chanisma/dxldog/docs/parts.md

# 부품 선정과 BOM

조사일: 2026-10-11 (가격은 ROBOTIS US 스토어 기준). ⚠️ 표시는 확인되지 않은 값이다.

## 1. 모터 선정: 시뮬레이션으로 정했다
- 모델: SpotMicro 치수(`sim/dog_model.py`). 질량은 CAD로 계산한 프린트 부품 무게에 모터·배터리·전자부품을 더했다. XL 구성 1.71 kg, XM 구성 1.91 kg.
- 방법: 모터 최대 힘을 각 모터의 **정지 토크(12 V)**로 제한하고 동작을 시켰다. 성공 여부와 함께 **RMS 토크 ÷ 정지 토크**(평균 부하율)를 쟀다.
- 기준: 서보는 평균 부하가 정지 토크의 약 30–40 %를 넘으면 오래 쓸 때 과열되기 쉽다(일반적인 경험칙 ⚠️).

| 모터 | 정지 토크 @12 V | 1개 가격 | 서기 (무릎) | 보통 걸음 (무릎 / 엉덩이) | 빠른 걸음 | 판단 |
|---|---|---|---|---|---|---|
| XL430-W250 | 1.5 Nm | $27.50 | 26 % | 성공, 58 % / 54 % | 성공, 75 % / 74 % | 서기·자세는 충분. **오래 걸으면 과열 위험** |
| XC430-W240 | 1.9 Nm | $137.89 | 21 % | 성공, 47 % / 43 % | 성공, 61 % / 55 % | XL보다 5배 비싸고 27 %만 셈 → 비추천 |
| XM430-W210 | 3.0 Nm | $310.39 | 15 % | 성공, 31 % / 30 % | 성공, 41 % / 37 % | 괜찮음 (더 빠름: 77 rpm) |
| **XM430-W350** | 4.1 Nm | $310.39 | 11 % | 성공, 23 % / 22 % | 성공, 30 % / 28 % | **여유 있음** |

추가로 확인한 것:
- **옆으로 벌리기(hip_x) 관절은 부하가 작다.** 평균 0.15–0.3 Nm라 XL430으로 충분하다. 그래서 권장 구성은 이 4개만 XL430으로 한다.
- **로봇을 80–90 % 크기로 줄여도** 걸을 때 XL430 부하는 40–55 %다. 걷는 동안의 부하는 몸무게보다 다리를 움직이는 동작에서 주로 오므로, 크게 줄지 않는다. 그래서 SpotMicro 원래 크기를 유지했다(`sim/scale_study.py`).
- 걸음새를 느리게 하면 부하가 줄어든다. XL430 기준: 빠름 69 % → 보통 61 % → 느림 51 % (`sim/gait_sweep.py`, CAD 반영 전 질량).
- 참고 논문(Open Ant, arXiv 2607.18488, 요약만 확인 ⚠️): 0.98 kg 로봇에서 XL430은 힘이 부족했고 XM430-W350은 충분했다고 보고했다.

## 2. 구성별 BOM (로봇 1대)
### 공통
| 품목 | 수량 | 가격 | 비고 |
|---|---|---|---|
| U2D2 (USB ↔ DYNAMIXEL) | 1 | $36.92 | PC나 Raspberry Pi에서 Python으로 제어 |
| U2D2 Power Hub Board Set | 1 | $21.85 | 3.5–24 V 입력을 모터 버스에 공급 |
| 12 V 직류 전원 (10 A 이상) | 1 | 약 $20–30 ⚠️ | 수업용 기본. XM430 8개를 쓰면 15 A 권장 ⚠️ |
| 3S LiPo 1300 mAh (ROBOTIS LB-020) + 충전기 LBC-010 | 선택 | $41.17 + $17.83 | 완충 12.6 V는 XL430 최대 12 V를 넘음 → 6장 참고 |
| IMU (예: BNO055) | 1 | 약 $30 ⚠️ | 기울기 측정 (J4 무게중심 실험) |
| Raspberry Pi 5 또는 4 | 선택 | 약 $60–80 ⚠️ | 몸에 싣는 두뇌. 윗판에 58×49 mm 구멍 있음 |
| 5 V 강압 변환기 (12 V → 5 V, Pi 5는 5 A / Pi 4는 3 A) + microSD 32 GB | Pi를 쓸 때 | 약 $15–25 ⚠️ | 모터 전원(12 V)에서 Pi 전원을 만든다 ([rpi_setup.md](rpi_setup.md)) |
| 필라멘트 PETG(또는 PLA) | 약 0.6 kg | – | 프린트 부품 합계 약 510 g (채움 30 % 어림) |
| TPU 필라멘트 | 소량 | – | 발 4개 |
| 나사 | 아래 표 | – | |

### 모터 (등급별)
| 등급 | 구성 | 모터 합계 | 공통 포함 합계(어림, Pi·배터리 제외) |
|---|---|---|---|
| 입문 | XL430-W250 × 12 | $330 | 약 $440 |
| **권장** | XL430-W250 × 4 (hip_x) + XM430-W350 × 8 (hip_y, knee) | $110 + $2,483 = **$2,593** | 약 $2,700 |
| 여유 | XM430-W350 × 12 | $3,725 | 약 $3,830 |

XL430 가격 $27.50은 2025년 $49.90에서 내린 값이다. 결제할 때 다시 확인한다 ⚠️.

### 나사 (1대 기준)
| 쓰임 | 나사 | 수량 |
|---|---|---|
| 포크 팔 ↔ 혼·아이들러 | M2 × 5–6 (팔 4 mm, 머리 자리 1.5 mm). STS3215는 M3 × 6 ([sts.md](sts.md)) | 관절 12 × 8 = 96 (XM은 혼 구멍이 8개지만 4개씩만 써도 됨) |
| 하우징·몸통 판 ↔ 모터 옆면 | XL/XC: M2.6 × 6 탭핑, XM: M2.5 × 6 | 모터 12 × 8 = 96 |
| 몸통 기둥 (위·아래 판) | M3 × 8 탭핑 | 8 |
| 발 ↔ 정강이 | M3 × 12 탭핑 | 4 |
| Raspberry Pi | M2.5 × 6 + 스페이서 | 4 |

XL430 상자에는 M2.6 탭핑 나사와 M2 볼트가 들어 있다(조사 요약 ⚠️). 부족한 양만 따로 산다.

## 3. 배선
- DYNAMIXEL TTL(3핀)을 줄줄이 잇는다(데이지 체인). 한 줄에 서보 3개 이하로 나누면 전류와 고장 위치를 관리하기 쉽다(커뮤니티 권장 ⚠️). 다리 하나를 한 줄로 하면 4줄 → Power Hub에서 나눈다.
- ID 배정 예시: FL 1·2·3, FR 4·5·6, RL 7·8·9, RR 10·11·12 (hip_x, hip_y, knee 순). 통신 속도 1 Mbps.

## 4. 전원 주의
- XL430: 6.5–12 V (권장 11.1 V). XM430: 10–14.8 V (권장 12 V). **섞어 쓸 때는 12 V 고정 전원**이 둘 다의 범위 안이다.
- 3S LiPo는 완충하면 12.6 V로 XL430 최대치를 넘는다(펌웨어 한계 14 V라 멈추지는 않지만 규격 밖이다). 배터리를 쓰려면 12 V 강압 레귤레이터를 넣는다 ⚠️ 대전류 레귤레이터를 따로 골라야 함.
