chanisma/dxldog/cad/out/sts/thigh_FR.step

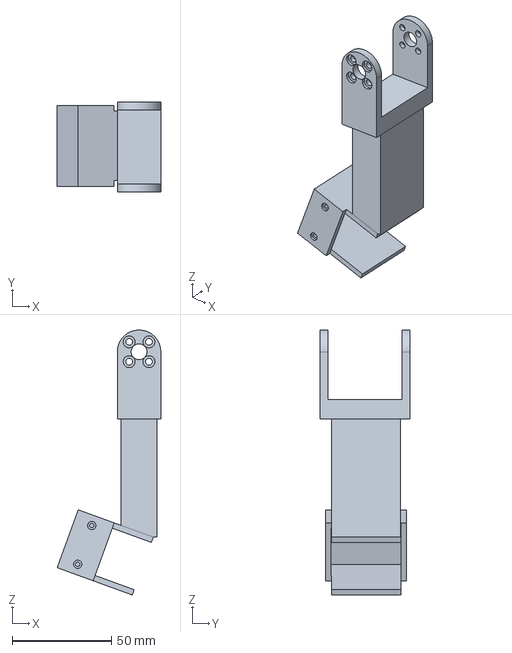
[picture p5: CAD file, 2026-10-14]
cad/out/sts/thigh_FR.step
52.4 x 45.4 x 133.8 mm
