chanisma/dxldog/cad/out/v2/sts/body_top.step

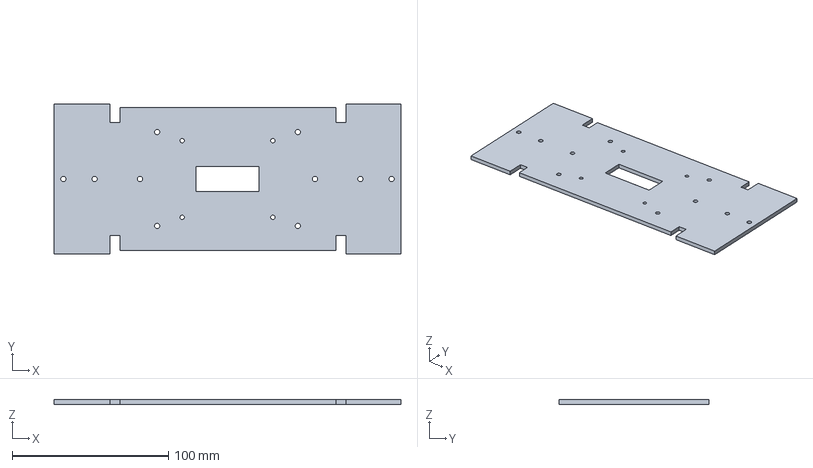
[picture p6: CAD file, 2026-10-14]
cad/out/v2/sts/body_top.step
222.0 x 96.0 x 3.00 mm
