chanisma/dxldog/software/dxldog/assets/mixed/shank_R.stl

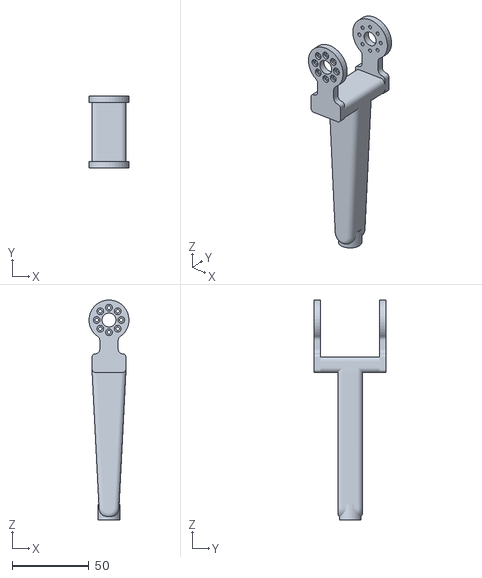
[picture p7: CAD file, 2026-10-11]
software/dxldog/assets/mixed/shank_R.stl
26.0 x 46.6 x 143.0
