chanisma/dxldog/software/dxldog/assets/sts/thigh_L.stl

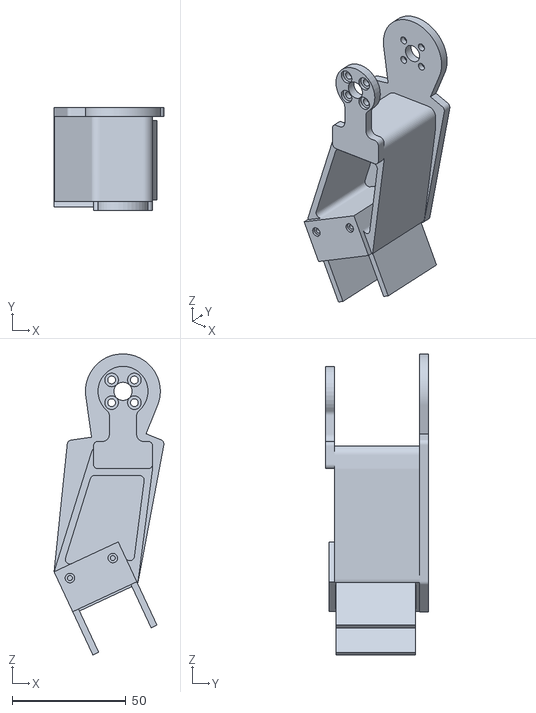
[picture p8: CAD file, 2026-10-14]
software/dxldog/assets/sts/thigh_L.stl
48.3 x 45.4 x 132.3
