chanisma/dxldog/cad/out/v2/mixed/gauge_side_holes.step

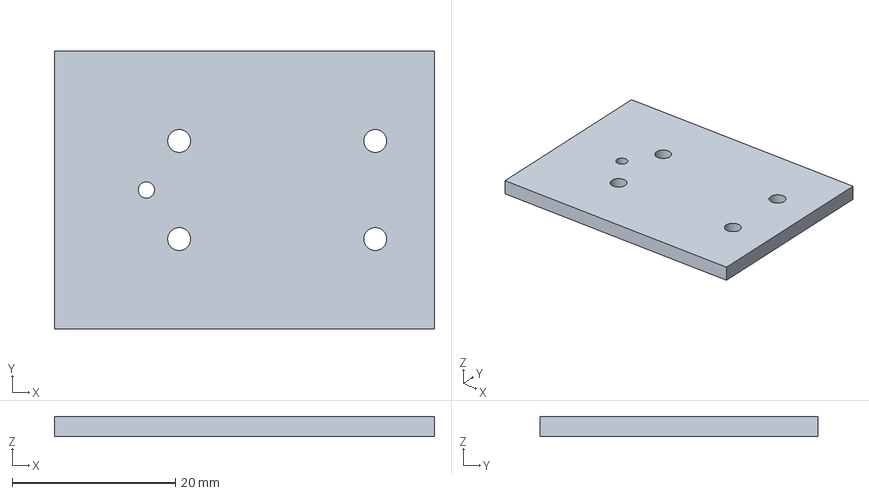
[picture p9: CAD file, 2026-10-11]
cad/out/v2/mixed/gauge_side_holes.step
46.5 x 34.0 x 2.50 mm
