chanisma/dxldog/cad/out/v2/sts/cover_mid.step

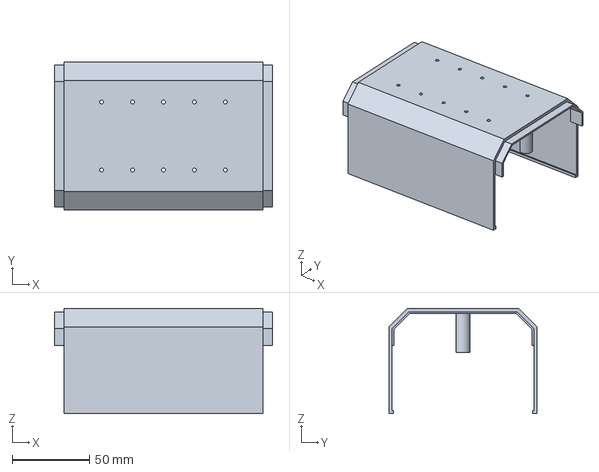
[picture p10: CAD file, 2026-10-14]
cad/out/v2/sts/cover_mid.step
141.0 x 96.0 x 68.0 mm
