chanisma/dxldog/software/dxldog/assets/mixed/body_bottom.stl

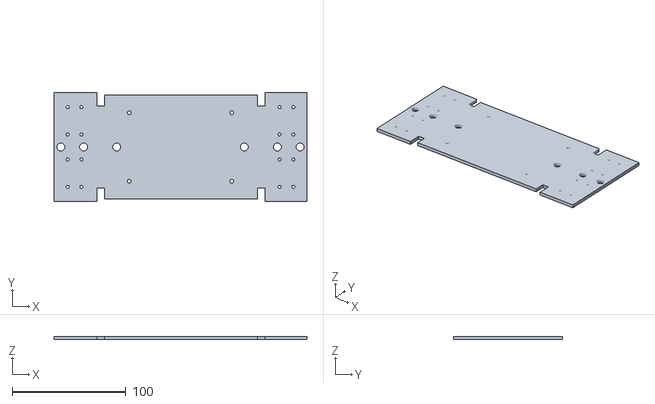
[picture p11: CAD file, 2026-10-11]
software/dxldog/assets/mixed/body_bottom.stl
222.0 x 96.0 x 3.00
