chanisma/dxldog/cad/out/sts/body_pillar.step

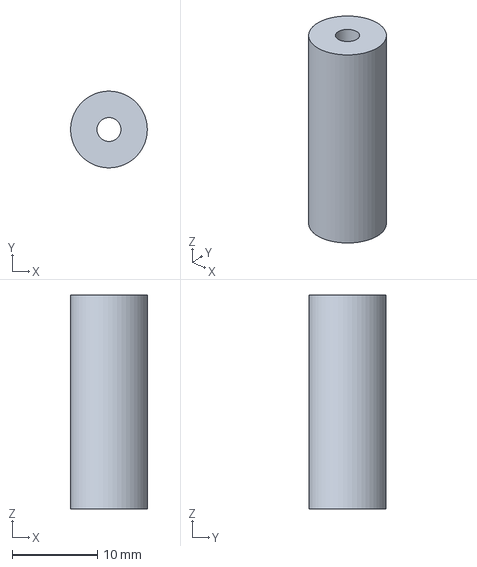
[picture p12: CAD file, 2026-10-14]
cad/out/sts/body_pillar.step
8.99 x 9.00 x 25.1 mm
