chanisma/dxldog/cad/out/v2/mixed/rail.step

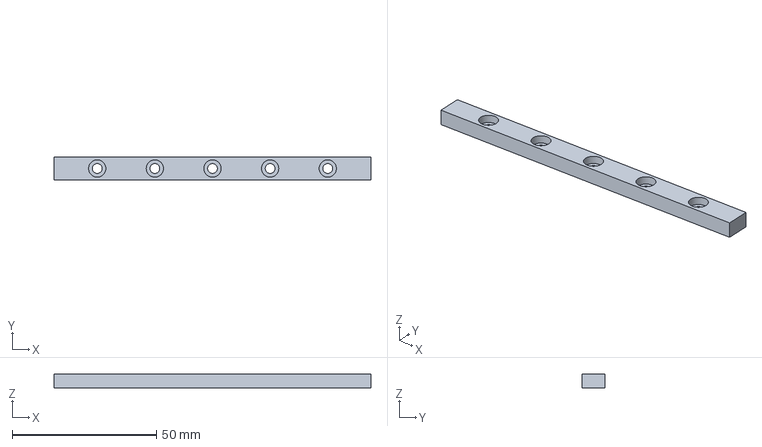
[picture p13: CAD file, 2026-10-11]
cad/out/v2/mixed/rail.step
110.0 x 8.00 x 5.00 mm
