chanisma/dxldog/software/dxldog/assets/mixed/shoulder_R.stl

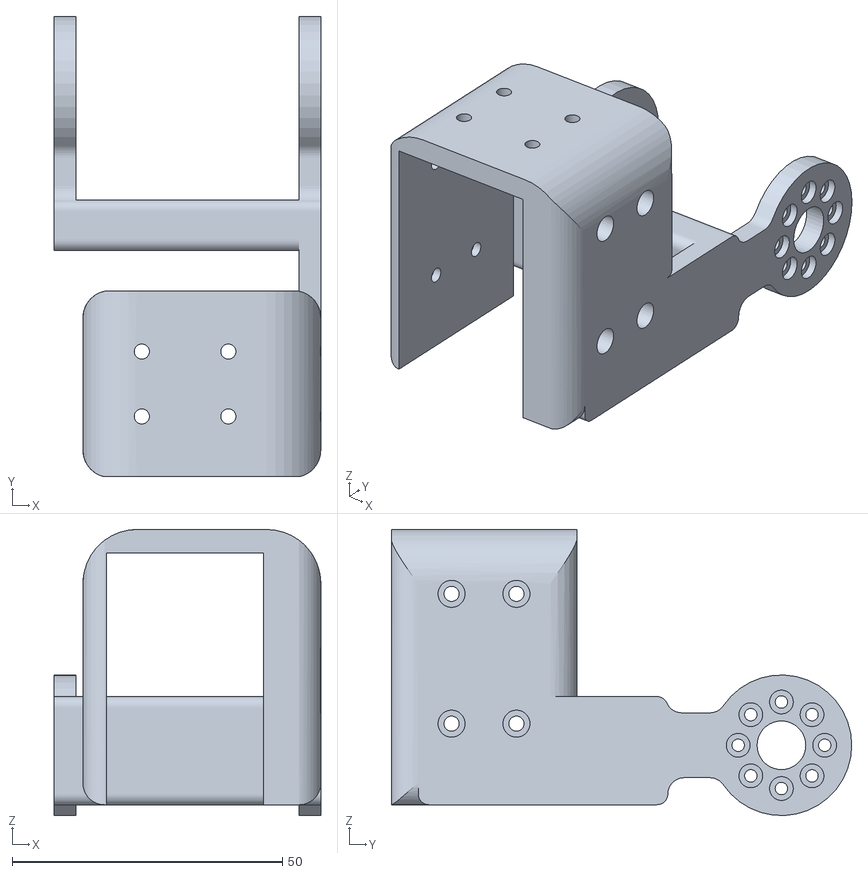
[picture p14: CAD file, 2026-10-11]
software/dxldog/assets/mixed/shoulder_R.stl
49.3 x 85.2 x 52.9
