chanisma/dxldog/software/dxldog/assets/sts/shoulder_R.stl

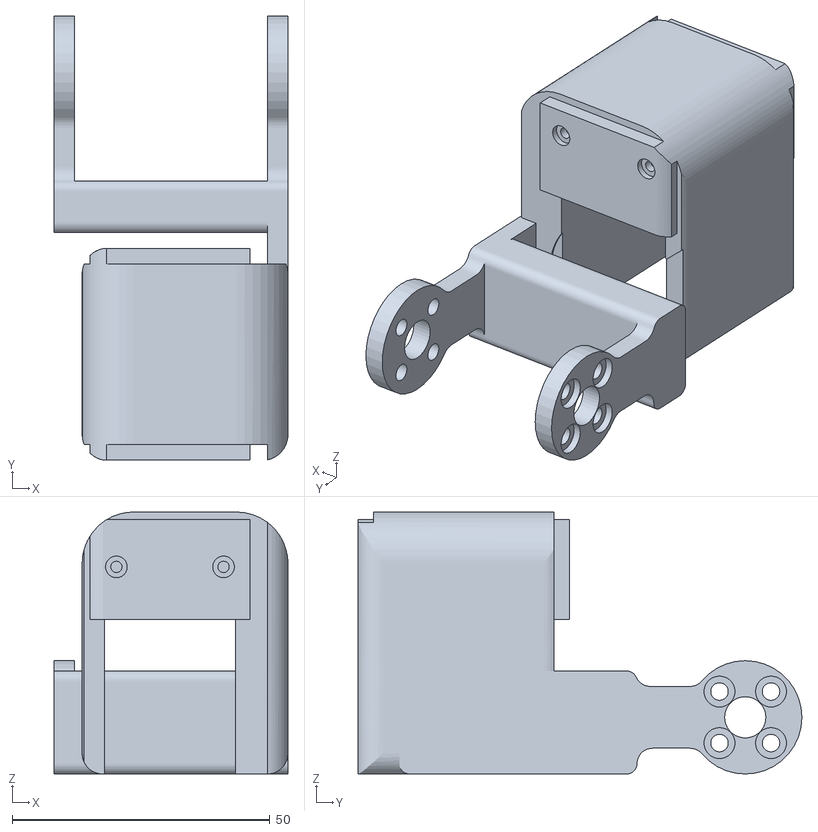
[picture p15: CAD file, 2026-10-14]
software/dxldog/assets/sts/shoulder_R.stl
45.4 x 86.2 x 50.8
