chanisma/dxldog/cad/out/v2/mixed/thigh_FR.step

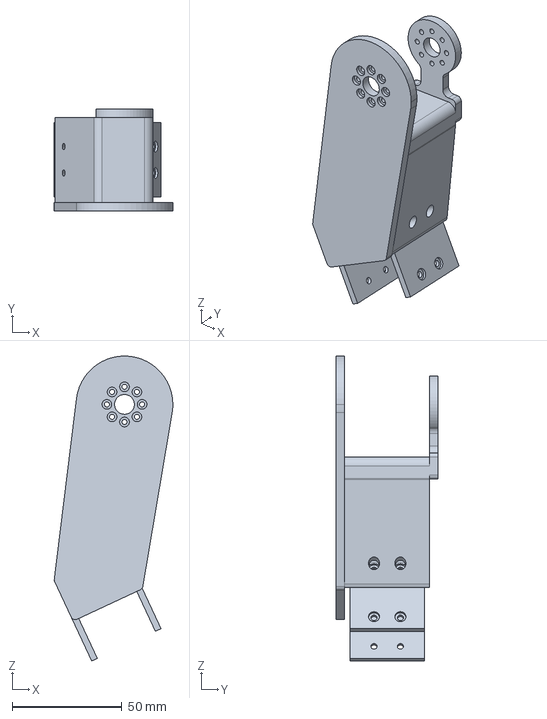
[picture p16: CAD file, 2026-10-11]
cad/out/v2/mixed/thigh_FR.step
54.0 x 46.6 x 138.7 mm
