chanisma/dxldog/software/dxldog/assets/mixed/cover.stl

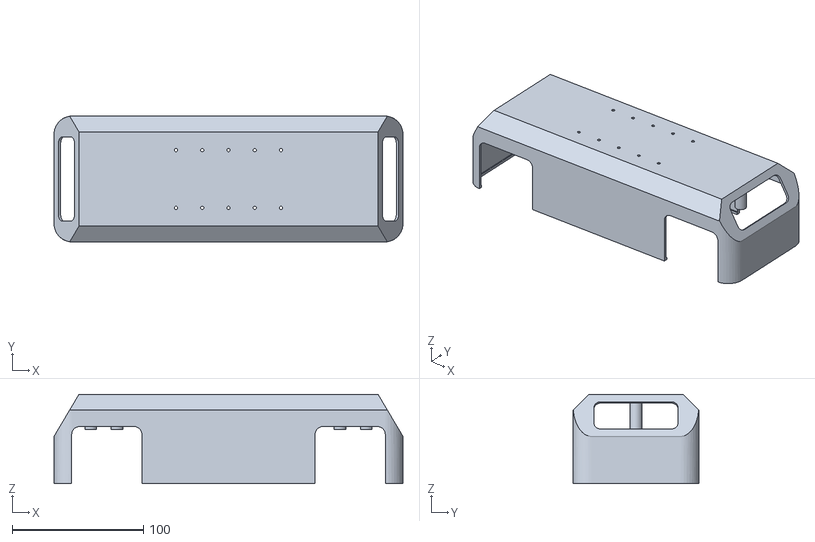
[picture p17: CAD file, 2026-10-11]
software/dxldog/assets/mixed/cover.stl
266.0 x 96.0 x 68.0
