chanisma/dxldog/software/dxldog/assets/sts/body_bottom.stl

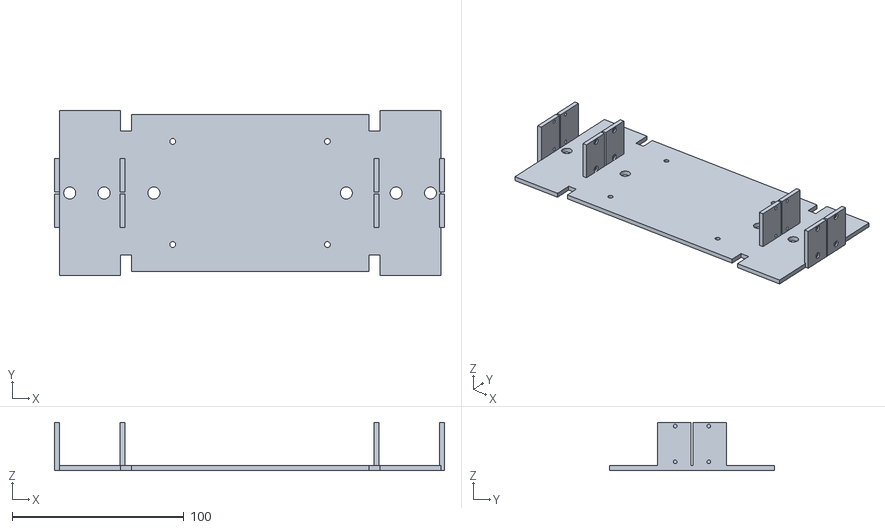
[picture p18: CAD file, 2026-10-14]
software/dxldog/assets/sts/body_bottom.stl
227.0 x 96.0 x 28.1
