chanisma/dxldog/cad/out/sts/shank_FR.step

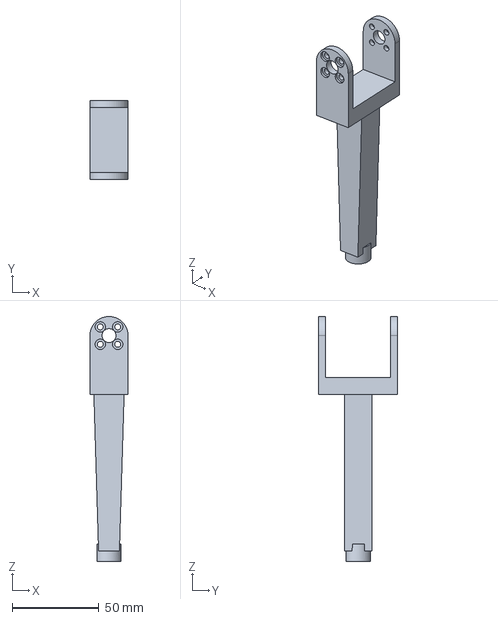
[picture p19: CAD file, 2026-10-14]
cad/out/sts/shank_FR.step
22.0 x 45.4 x 141.0 mm
