chanisma/dxldog/cad/out/v2/sts/gauge_face_top.step

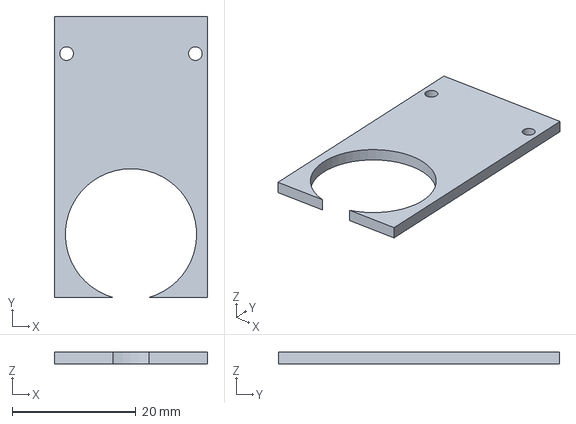
[picture p20: CAD file, 2026-10-14]
cad/out/v2/sts/gauge_face_top.step
24.8 x 45.4 x 2.00 mm
