chanisma/dxldog/cad/out/v2/sts/gauge_case_ring.step

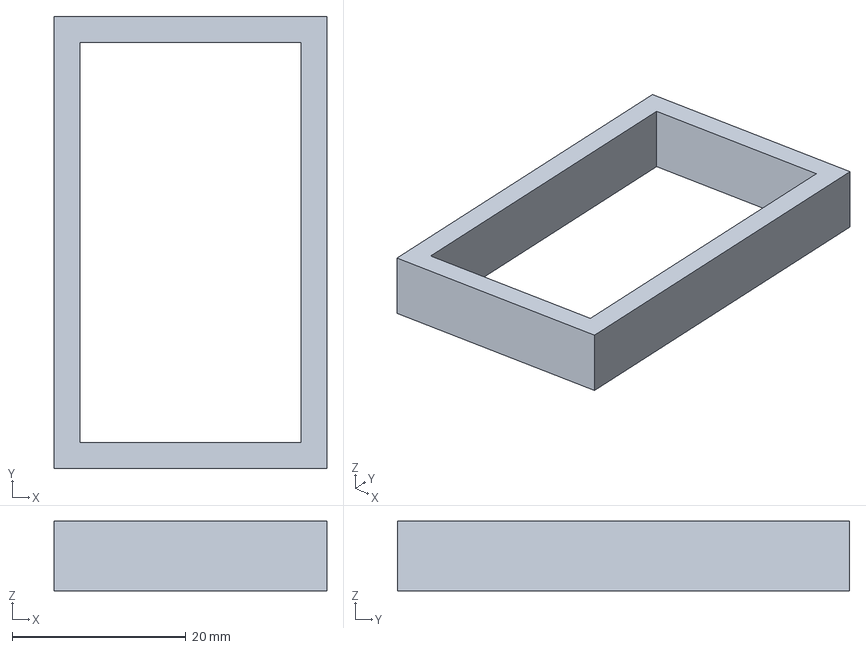
[picture p21: CAD file, 2026-10-14]
cad/out/v2/sts/gauge_case_ring.step
31.4 x 52.0 x 8.00 mm
