chanisma/dxldog/software/dxldog/assets/sts/shank_R.stl

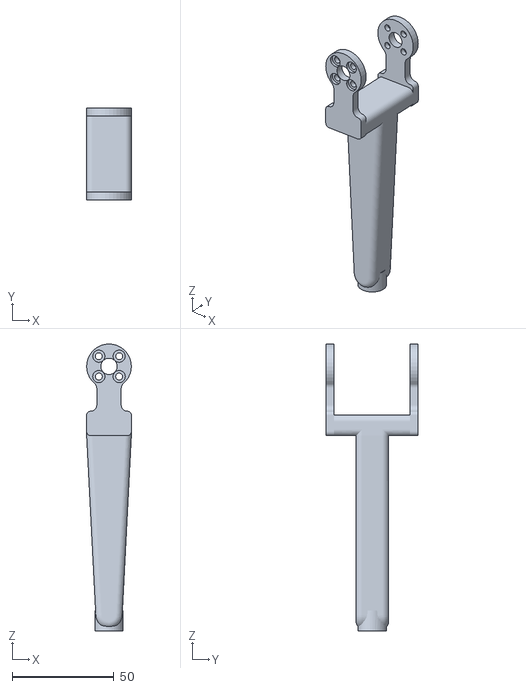
[picture p22: CAD file, 2026-10-14]
software/dxldog/assets/sts/shank_R.stl
22.0 x 45.4 x 141.0
