chanisma/dxldog/cad/out/sts/body_bottom.step

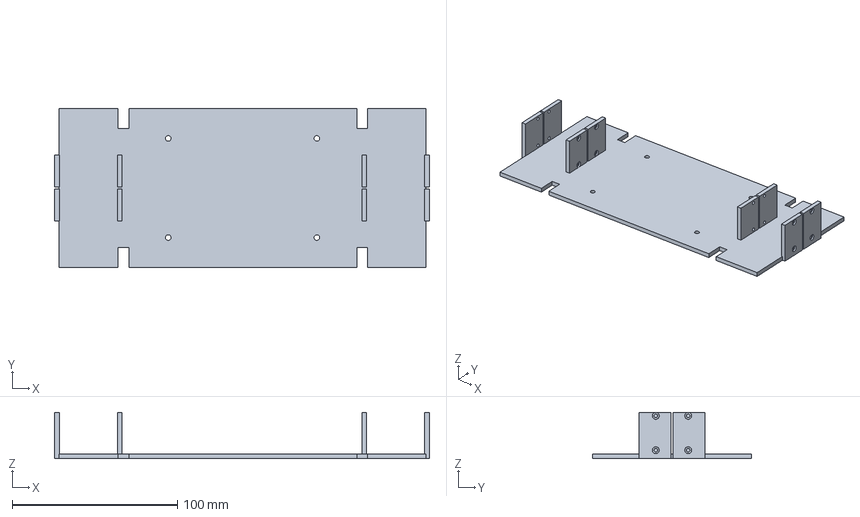
[picture p23: CAD file, 2026-10-14]
cad/out/sts/body_bottom.step
227.0 x 96.0 x 28.1 mm
