chanisma/dxldog/cad/out/v2/mixed/body_pillar.step

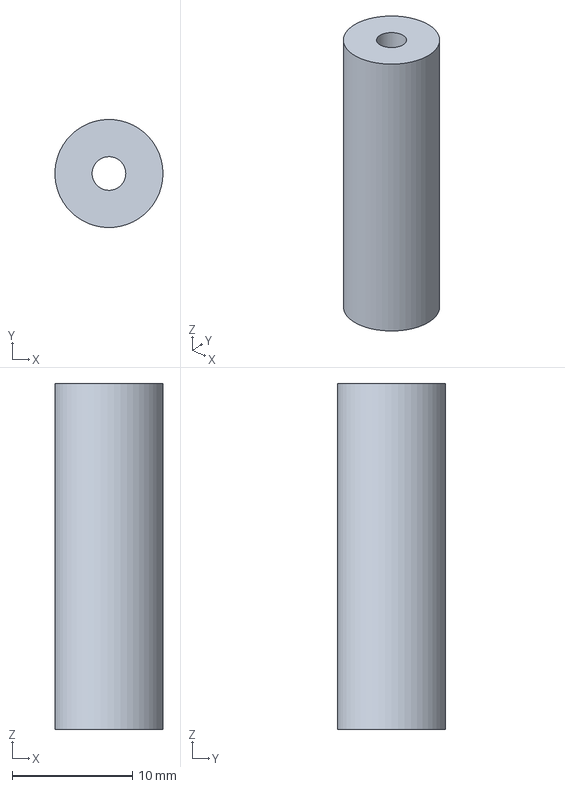
[picture p24: CAD file, 2026-10-11]
cad/out/v2/mixed/body_pillar.step
8.99 x 9.00 x 28.8 mm
