chanisma/dxldog/cad/out/sts/shoulder_FL.step

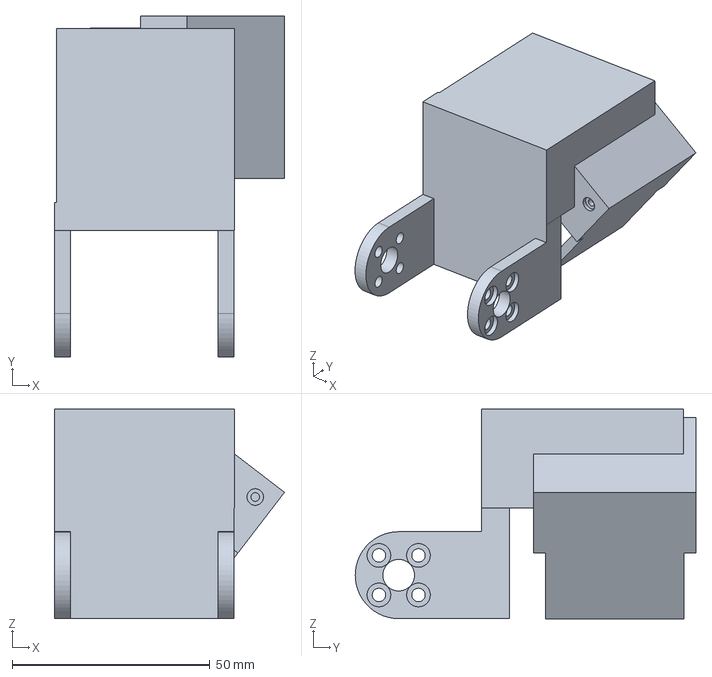
[picture p25: CAD file, 2026-10-14]
cad/out/sts/shoulder_FL.step
58.2 x 86.2 x 53.1 mm
