chanisma/dxldog/cad/out/v2/mixed/cover_end.step

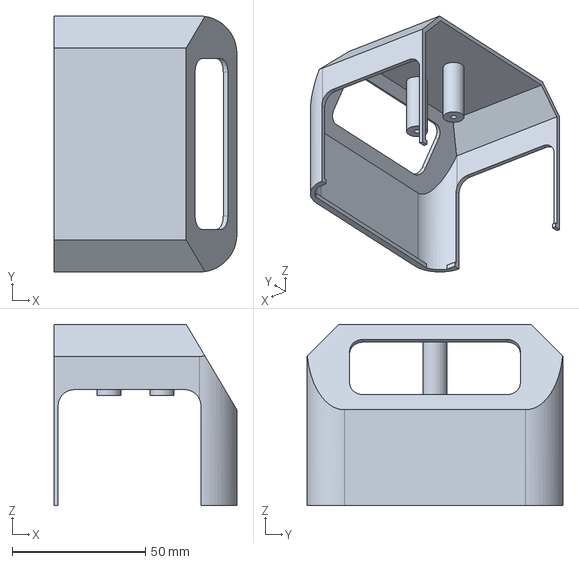
[picture p26: CAD file, 2026-10-11]
cad/out/v2/mixed/cover_end.step
68.5 x 96.0 x 68.0 mm
