chanisma/dxldog/software/dxldog/assets/mixed/cover_dark.stl

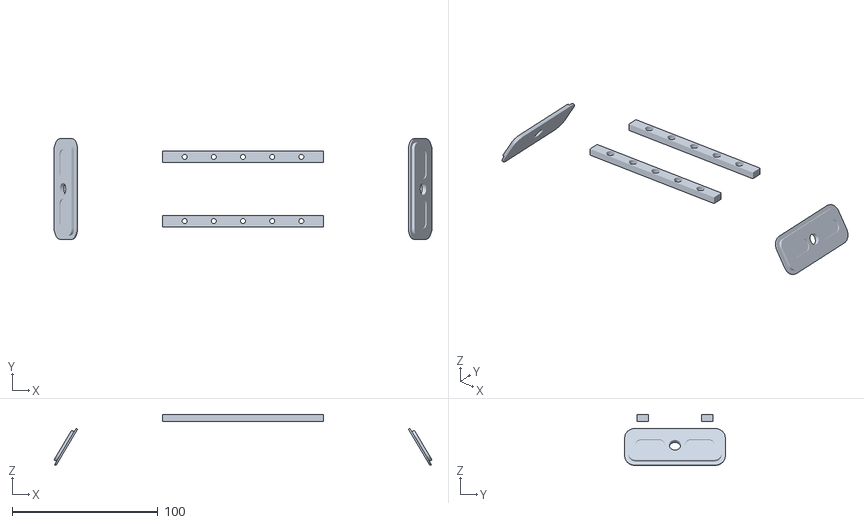
[picture p27: CAD file, 2026-10-11]
software/dxldog/assets/mixed/cover_dark.stl
259.0 x 69.0 x 35.1
