chanisma/dxldog/cad/out/sts/foot.step

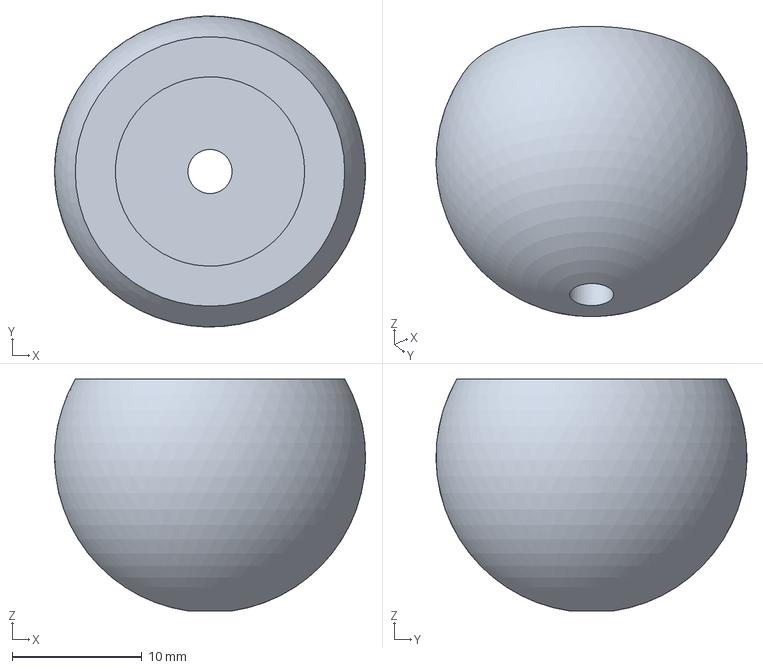
[picture p28: CAD file, 2026-10-14]
cad/out/sts/foot.step
24.0 x 24.0 x 17.9 mm
