chanisma/dxldog/cad/out/v2/mixed/gauge_horn.step

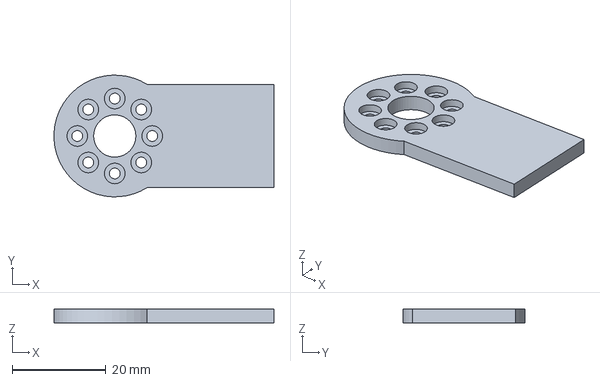
[picture p29: CAD file, 2026-10-11]
cad/out/v2/mixed/gauge_horn.step
47.0 x 26.0 x 3.00 mm
