chanisma/dxldog/cad/out/v2/mixed/cover_mid.step

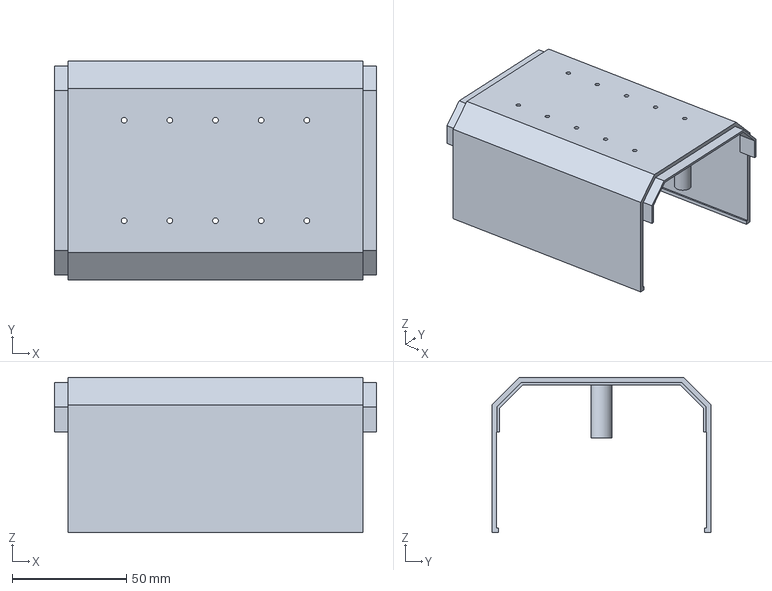
[picture p30: CAD file, 2026-10-11]
cad/out/v2/mixed/cover_mid.step
141.0 x 96.0 x 68.0 mm
