chanisma/dxldog/cad/out/sts/gauge_horn.step

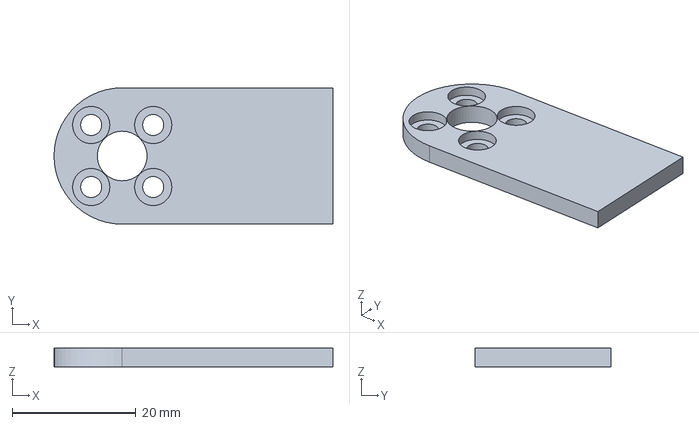
[picture p31: CAD file, 2026-10-14]
cad/out/sts/gauge_horn.step
45.0 x 22.0 x 3.00 mm
