chanisma/dxldog/cad/out/v2/sts/face_plate.step

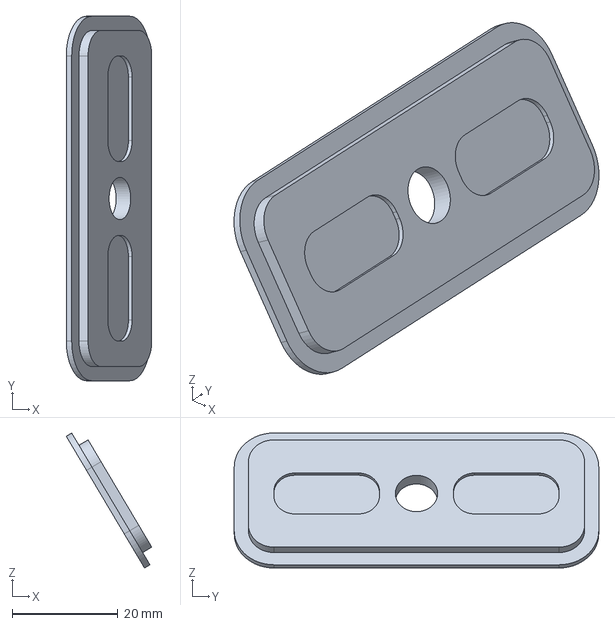
[picture p32: CAD file, 2026-10-14]
cad/out/v2/sts/face_plate.step
16.2 x 69.0 x 25.5 mm
