chanisma/dxldog/cad/out/v2/mixed/gauge_case_ring.step

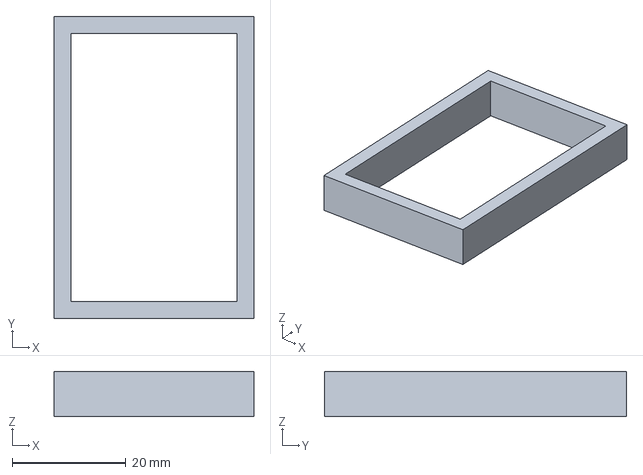
[picture p33: CAD file, 2026-10-11]
cad/out/v2/mixed/gauge_case_ring.step
35.1 x 53.1 x 8.00 mm
