chanisma/dxldog/(list of files, cad)

Other CAD files:
software/dxldog/assets/sts/thigh_R.stl
cad/out/v2/sts/thigh_FR.step
cad/out/sts/thigh_FL.step
cad/out/v2/mixed/body_bottom.step
software/dxldog/assets/mixed/shoulder_L.stl
software/dxldog/assets/sts/shoulder_L.stl
cad/out/sts/body_top.step
cad/out/v2/mixed/thigh_FL.step
software/dxldog/assets/mixed/body_top.stl
cad/out/v2/mixed/shank_FL.step
cad/out/v2/sts/body_bottom.step
software/dxldog/assets/mixed/shank_L.stl
software/dxldog/assets/sts/shank_L.stl
cad/out/sts/shank_FL.step
cad/out/v2/mixed/shoulder_FL.step
cad/out/v2/sts/gauge_face_bottom.step
software/dxldog/assets/mixed/thigh_L.stl
software/dxldog/assets/sts/body_top.stl
cad/out/sts/gauge_case_ring.step
cad/out/v2/sts/rail.step
software/dxldog/assets/mixed/thigh_R.stl
software/dxldog/assets/sts/cover.stl
cad/out/v2/sts/shoulder_FR.step
cad/out/v2/mixed/foot.step
cad/out/v2/sts/thigh_FL.step
software/dxldog/assets/mixed/foot.stl
software/dxldog/assets/sts/foot.stl
cad/out/sts/shoulder_FR.step
cad/out/v2/sts/shank_FR.step
cad/out/sts/gauge_face_top.step
cad/out/v2/sts/cover_end.step
cad/out/v2/mixed/body_top.step
cad/out/sts/gauge_face_bottom.step
cad/out/v2/mixed/shoulder_FR.step
cad/out/v2/sts/foot.step
cad/out/v2/mixed/face_plate.step
cad/out/v2/sts/gauge_horn.step
cad/out/v2/sts/body_pillar.step
cad/out/v2/mixed/shank_FR.step
cad/out/v2/sts/shoulder_FL.step
cad/out/v2/sts/shank_FL.step
cad/out/mixed/body_bottom.step
cad/out/mixed/body_bottom.stl
cad/out/mixed/body_pillar.step
cad/out/mixed/body_top.step
cad/out/mixed/body_top.stl
cad/out/mixed/foot.step
cad/out/mixed/gauge_case_ring.step
cad/out/mixed/gauge_horn.step
cad/out/mixed/gauge_horn.stl
cad/out/mixed/gauge_side_holes.step
cad/out/mixed/shank_FL.step
cad/out/mixed/shank_FL.stl
cad/out/mixed/shank_FR.step
cad/out/mixed/shank_FR.stl
cad/out/mixed/shoulder_FL.step
cad/out/mixed/shoulder_FL.stl
cad/out/mixed/shoulder_FR.step
cad/out/mixed/shoulder_FR.stl
cad/out/mixed/thigh_FL.step
cad/out/mixed/thigh_FL.stl
cad/out/mixed/thigh_FR.step
cad/out/mixed/thigh_FR.stl
cad/out/sts/body_bottom.stl
cad/out/sts/gauge_horn.stl
cad/out/sts/gauge_horn_screw.step
cad/out/sts/gauge_horn_screw.stl
cad/out/sts/shank_FL.stl
cad/out/sts/shank_FR.stl
cad/out/sts/shoulder_FL.stl
cad/out/sts/shoulder_FR.stl
cad/out/sts/thigh_FL.stl
cad/out/sts/thigh_FR.stl
cad/out/v2/mixed/body_bottom.stl
cad/out/v2/mixed/body_pillar.stl
cad/out/v2/mixed/body_top.stl
cad/out/v2/mixed/cover_end.stl
cad/out/v2/mixed/cover_mid.stl
cad/out/v2/mixed/face_plate.stl
cad/out/v2/mixed/foot.stl
cad/out/v2/mixed/gauge_case_ring.stl
cad/out/v2/mixed/gauge_horn.stl
cad/out/v2/mixed/gauge_horn_screw.step
cad/out/v2/mixed/gauge_horn_screw.stl
cad/out/v2/mixed/gauge_side_holes.stl
cad/out/v2/mixed/rail.stl
cad/out/v2/mixed/shank_FL.stl
cad/out/v2/mixed/shank_FR.stl
cad/out/v2/mixed/shoulder_FL.stl
cad/out/v2/mixed/shoulder_FR.stl
cad/out/v2/mixed/thigh_FL.stl
cad/out/v2/mixed/thigh_FR.stl
cad/out/v2/sts/body_bottom.stl
cad/out/v2/sts/body_pillar.stl
cad/out/v2/sts/body_top.stl
cad/out/v2/sts/cover_end.stl
cad/out/v2/sts/cover_mid.stl
cad/out/v2/sts/face_plate.stl
cad/out/v2/sts/foot.stl
cad/out/v2/sts/gauge_case_ring.stl
cad/out/v2/sts/gauge_face_bottom.stl
cad/out/v2/sts/gauge_face_top.stl
cad/out/v2/sts/gauge_horn.stl
cad/out/v2/sts/gauge_horn_screw.step
cad/out/v2/sts/gauge_horn_screw.stl
cad/out/v2/sts/rail.stl
cad/out/v2/sts/shank_FL.stl
cad/out/v2/sts/shank_FR.stl
cad/out/v2/sts/shoulder_FL.stl
cad/out/v2/sts/shoulder_FR.stl
cad/out/v2/sts/thigh_FL.stl
cad/out/v2/sts/thigh_FR.stl
cad/out/xl/body_bottom.step
cad/out/xl/body_bottom.stl
cad/out/xl/body_pillar.step
cad/out/xl/body_top.step
cad/out/xl/body_top.stl
cad/out/xl/foot.step
cad/out/xl/gauge_case_ring.step
cad/out/xl/gauge_horn.step
cad/out/xl/gauge_horn.stl
cad/out/xl/gauge_side_holes.step
cad/out/xl/shank_FL.step
cad/out/xl/shank_FL.stl
cad/out/xl/shank_FR.step
cad/out/xl/shank_FR.stl
cad/out/xl/shoulder_FL.step
cad/out/xl/shoulder_FL.stl
cad/out/xl/shoulder_FR.step
cad/out/xl/shoulder_FR.stl
cad/out/xl/thigh_FL.step
cad/out/xl/thigh_FL.stl
cad/out/xl/thigh_FR.step
cad/out/xl/thigh_FR.stl
cad/out/xm/body_bottom.step
cad/out/xm/body_bottom.stl
cad/out/xm/body_pillar.step
cad/out/xm/body_top.step
cad/out/xm/body_top.stl
cad/out/xm/foot.step
cad/out/xm/gauge_case_ring.step
cad/out/xm/gauge_horn.step
cad/out/xm/gauge_horn.stl
cad/out/xm/gauge_side_holes.step
cad/out/xm/shank_FL.step
cad/out/xm/shank_FL.stl
cad/out/xm/shank_FR.step
cad/out/xm/shank_FR.stl
cad/out/xm/shoulder_FL.step
cad/out/xm/shoulder_FL.stl
cad/out/xm/shoulder_FR.step
cad/out/xm/shoulder_FR.stl
cad/out/xm/thigh_FL.step
cad/out/xm/thigh_FL.stl
cad/out/xm/thigh_FR.step
cad/out/xm/thigh_FR.stl
