chanisma/dxldog/(commit log)

2026-10-11 DXL Dog: SpotMicro redesigned for DYNAMIXEL X430 — CAD, sim, robot software
    - sim/: torque studies for motor selection (XL430 vs XM430, gait sweeps)
    - cad/: parametric build123d CAD (xl/xm/mixed), collision check, renders, STL/STEP
    - software/: Dog API shared by simulator (MuJoCo, CAD meshes/masses) and real
    robot (dynamixel_sdk, U2D2, laptop or Raspberry Pi), FakeBus, setup/calibration
    tools, lessons J1-J5, DXL Dog Studio web UI with digital twin
    - Balanced stand pose and duty-0.65 trot (COM is 2.6 cm behind hip center)
    - docs/: plan, parts/BOM, design, software, Raspberry Pi setup
    [body_bottom.step, body_bottom.stl, body_pillar.step, body_pillar.stl, body_top.step, body_top.stl, foot.step, foot.stl]
2026-10-11 Add STS3215 (LeRobot) variant, IMU balance, and walking fixes
    - CAD: generalize Motor dimensions, add STS3215 (measured from SO-ARM100
    mesh), face-mount housing tabs, hip_x walls, fit gauges; sts variant
    builds and passes collision check (405 poses)
    - Software: robot selection (--robot / DXLDOG_ROBOT / tools use), Feetech
    StsBus via scservo_sdk, per-robot sim assets and calibration file
    - Walking: shift stance so feet sit behind hips, trot duty/turn params
    - Balance: Dog.set_balance(), get_gyro(), lesson J6
    - Studio: robot badge, duty/turn sliders
    - Docs: docs/sts.md and updates; tests for buses and all lessons
    [body_bottom.step, body_bottom.stl, body_pillar.step, body_pillar.stl, body_top.step, body_top.stl, foot.step, foot.stl]
2026-10-11 Add v2 Spot-inspired design; switch simulator to v2; fix STS v1 bugs
    - cad/dxldog_v2.py: body covers with chamfered top, face plates with
    camera window, top rails; upright hip_y pod with rounded edges; thigh
    with one-piece outer panel and in-line knee motor; slim rounded shank
    - build_all/check/render/export_sim_assets take a v1|v2 style argument;
    check now covers rear legs, rear hip_x motors, covers and knee 0 deg
    - Fix STS v1: face tabs floated 0.15 mm off housing walls; rear hip_x
    walls on the bottom plate were mirrored instead of translated
    - Simulator/studio use v2 assets (cover meshes, Spot colors, body box)
    - Docs: design_v2.md, README, design/sts/software updates
    Co-Authored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
    [body_bottom.step, body_bottom.stl, body_pillar.step, body_pillar.stl, body_top.step, body_top.stl, cover.stl, cover_dark.stl]
